vtremblay/ambiens-sc1-ctrl-board/pcb/ambiens-sc1.kicad_pcb

## KiCad design pcb/ambiens-sc1.kicad_pcb (2024-04-04)

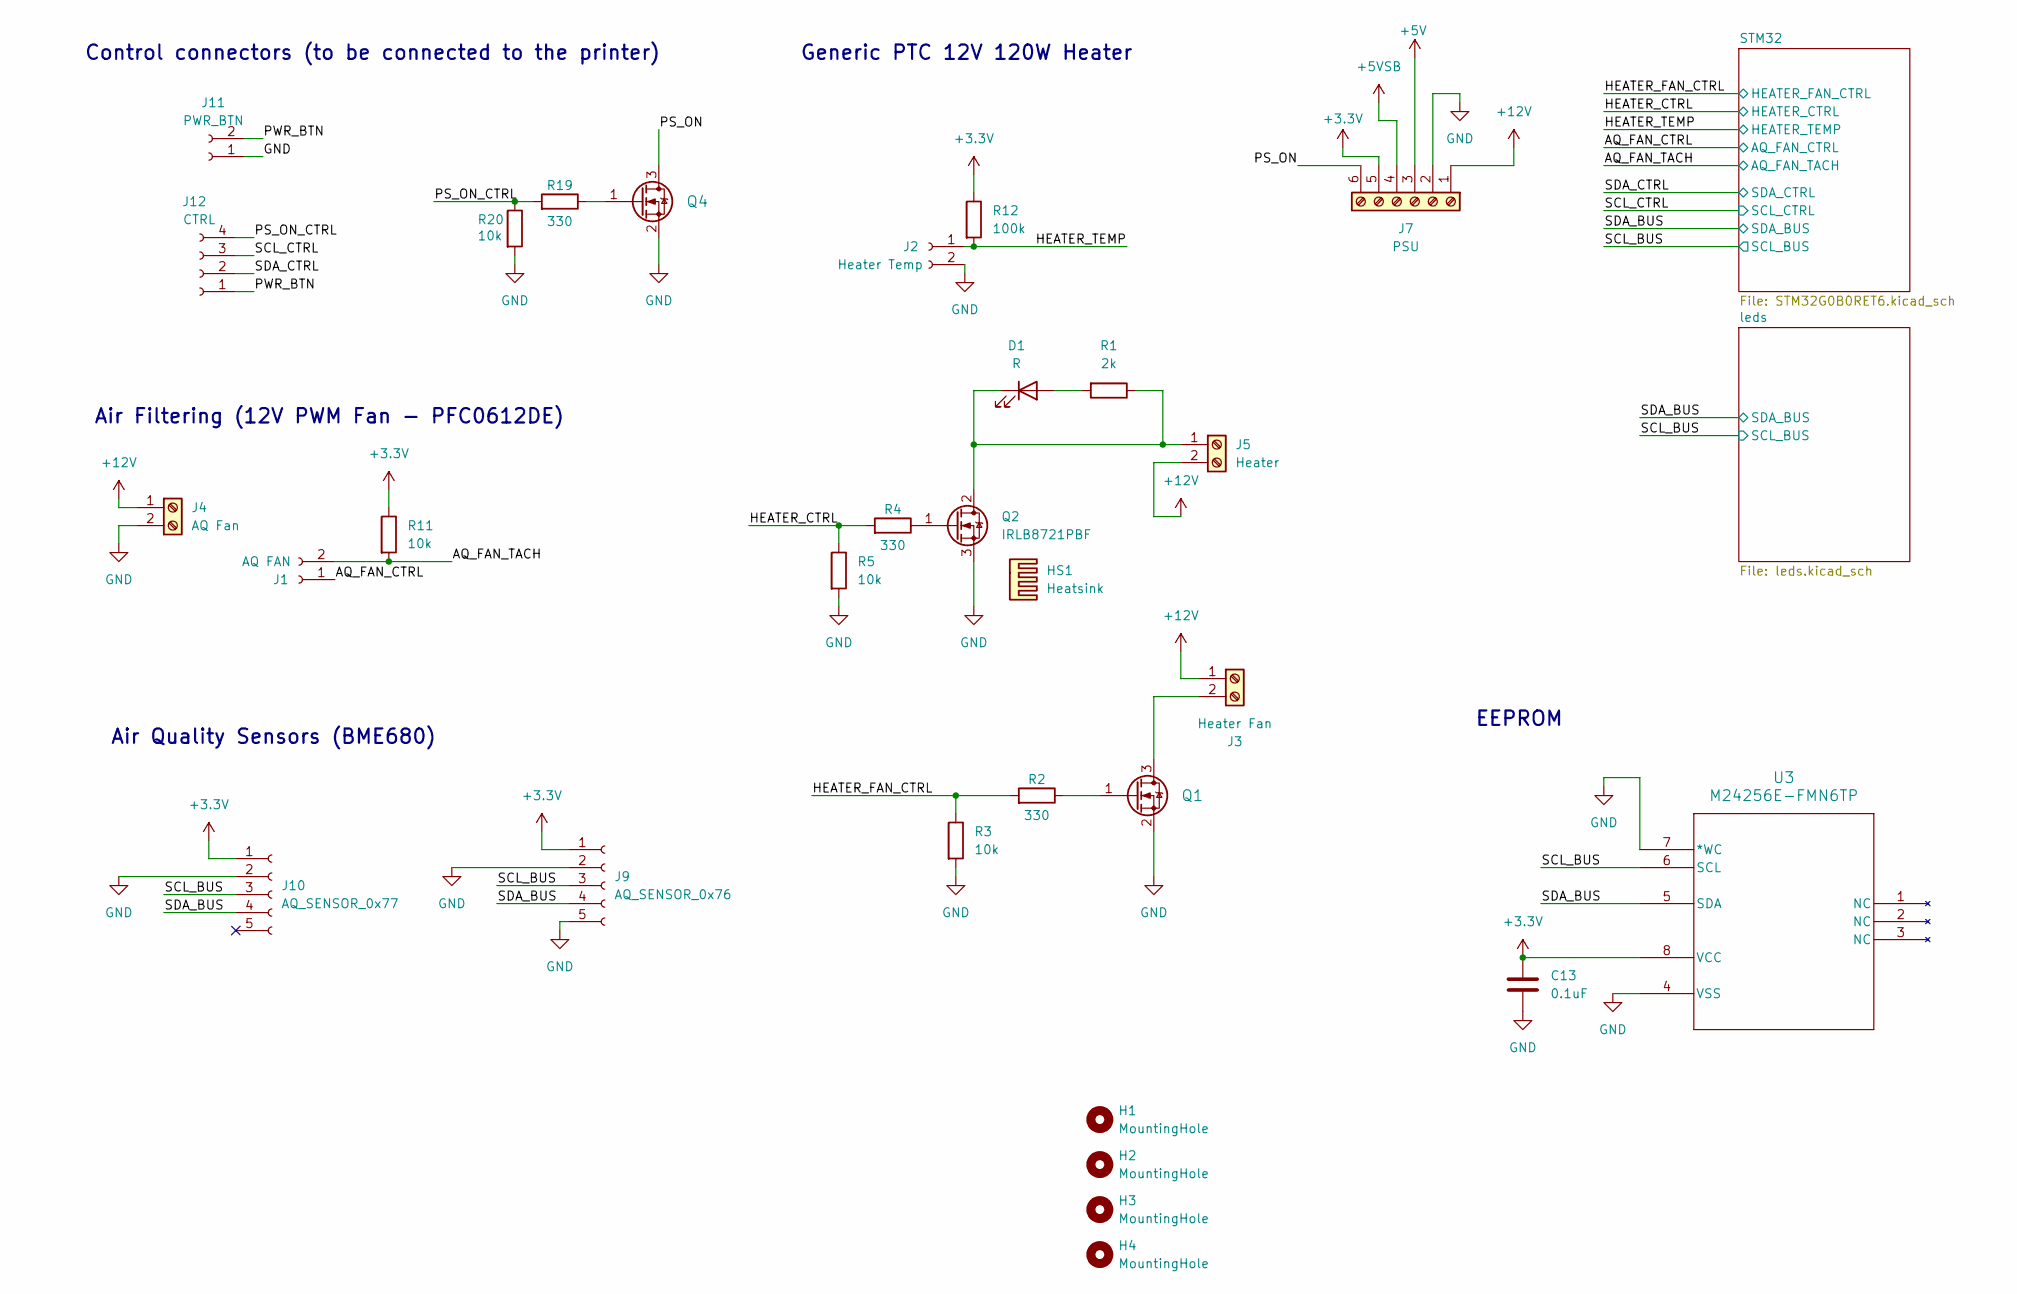
[picture p4: schematic ambiens-sc1.kicad_sch]

Parts:
C13: 0.1uF; C_0603_1608Metric
D1: R; LED_0805_2012Metric
H1, H2, H3, H4: MountingHole; MountingHole_3.2mm_M3
HS1: Heatsink; heatsink-15x10mm
J1: AQ FAN; JST_XH_B2B-XH-A_1x02_P2.50mm_Vertical
J2: Heater Temp; JST_XH_B2B-XH-A_1x02_P2.50mm_Vertical
J3: Heater Fan; TerminalBlock_Phoenix_MKDS-1,5-2_1x02_P5.00mm_Horizontal
J4: AQ Fan; TerminalBlock_Phoenix_MKDS-1,5-2_1x02_P5.00mm_Horizontal
J5: Heater; TerminalBlock_Phoenix_MKDS-1,5-2_1x02_P5.00mm_Horizontal
J7: PSU; TerminalBlock_Phoenix_MKDS-1,5-6-5.08_1x06_P5.08mm_Horizont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
J9: AQ_SENSOR_0x76; JST_XH_B5B-XH-A_1x05_P2.50mm_Vertical
J10: AQ_SENSOR_0x77; JST_XH_B5B-XH-A_1x05_P2.50mm_Vertical
J11: PWR_BTN; JST_XH_B2B-XH-A_1x02_P2.50mm_Vertical
J12: CTRL; JST_XH_B4B-XH-A_1x04_P2.50mm_Vertical
Q1, Q4: SI2302; SOT-23-3
Q2: IRLB8721PBF; TO-220-3_Vertical
R1: 2k; R_0805_2012Metric
R2, R4, R19: 330; R_0805_2012Metric
R3, R5, R11, R20: 10k; R_0805_2012Metric
R12: 100k; R_0805_2012Metric
U3: M24256E-FMN6TP; SO8N_4X5X1P27_STM

Connections:
+3.3V: C13.1, J7.5, J9.1, J10.1, R11.1, R12.1, U3.8 (VCC); also elsewhere on the board
+5V: J7.3; also elsewhere on the board
+5VSB: J7.4; also elsewhere on the board
+12V: J3.1, J4.1, J5.2, J7.1; also elsewhere on the board
/AQ_FAN_CTRL: J1.1; also elsewhere on the board
/AQ_FAN_TACH: J1.2, R11.2; also elsewhere on the board
/HEATER_CTRL: R4.2, R5.1; also elsewhere on the board
/HEATER_FAN_CTRL: R2.2, R3.1; also elsewhere on the board
/HEATER_TEMP: J2.1, R12.2; also elsewhere on the board
/PS_ON: J7.6, Q4.3 (D)
/PS_ON_CTRL: J12.4, R19.2, R20.1
/PWR_BTN: J11.2, J12.1
/SCL_BUS: J9.3, J10.3, U3.6 (SCL); also elsewhere on the board
/SCL_CTRL: J12.3; also elsewhere on the board
/SDA_BUS: J9.4, J10.4, U3.5 (SDA); also elsewhere on the board
/SDA_CTRL: J12.2; also elsewhere on the board
GND: C13.2, J2.2, J4.2, J7.2, J9.2, J9.5, J10.2, J11.1, Q1.2 (S), Q2.3 (S), Q4.2 (S), R3.2, R5.2, R20.2, U3.4 (VSS), U3.7 (*WC); also elsewhere on the board
unnamed: D1.2 (A), R1.2
unnamed: D1.1 (K), J5.1, Q2.2 (D), R1.1
unnamed: J3.2, Q1.3 (D)
unnamed: Q1.1 (G), R2.1
unnamed: Q2.1 (G), R4.1
unnamed: Q4.1 (G), R19.1

Notes on the sheet:
Air Quality Sensors (BME680)
Generic PTC 12V 120W Heater
Control connectors (to be connected to the printer)
EEPROM
Air Filtering (12V PWM Fan - PFC0612DE)

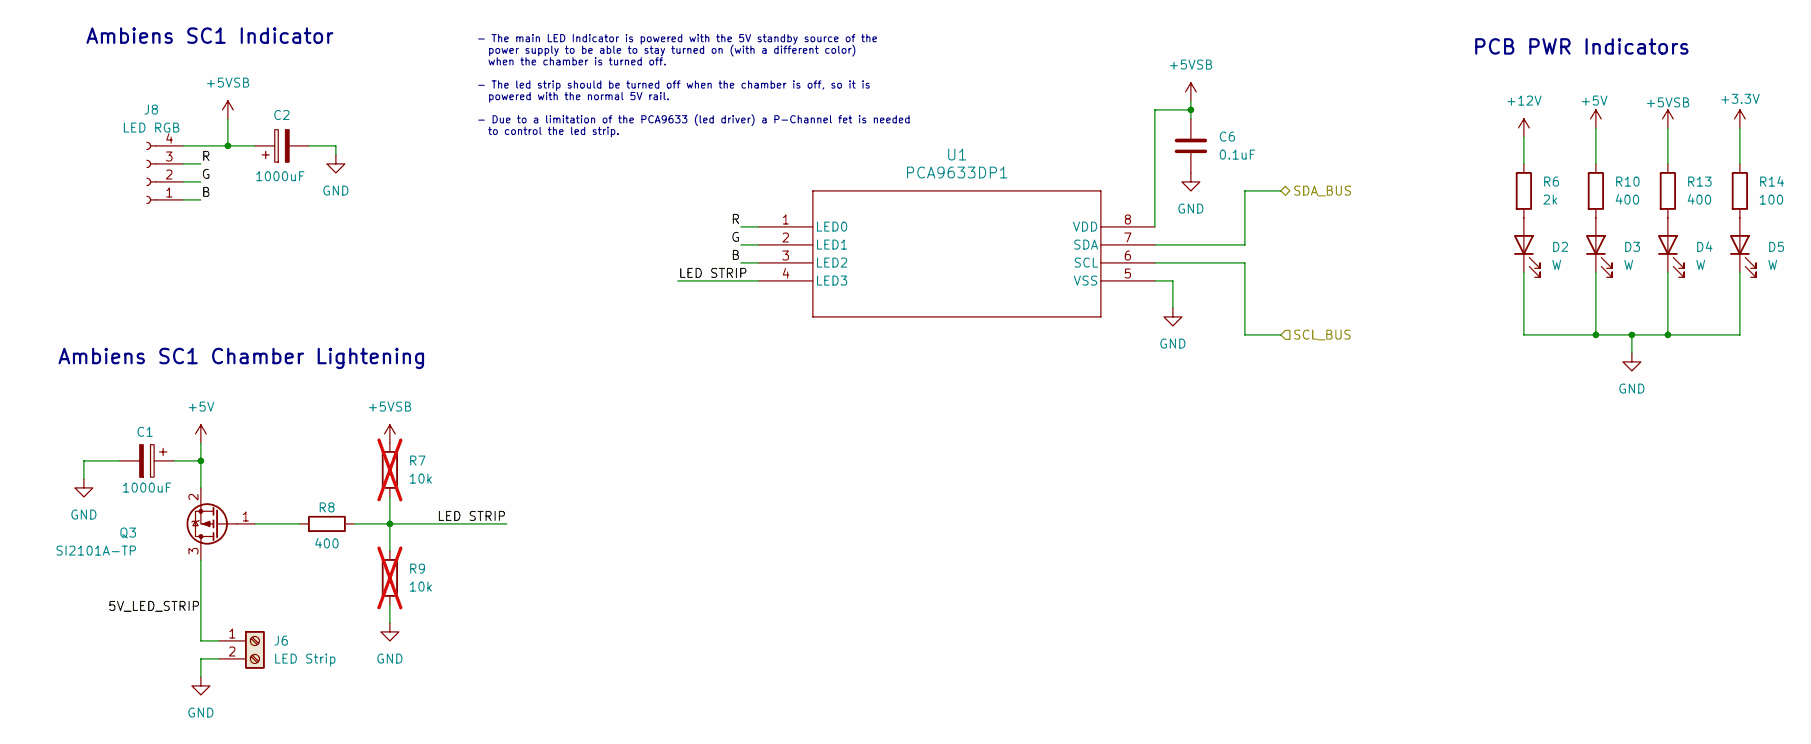
[picture p5: schematic leds.kicad_sch]

Parts:
C1, C2: 1000uF; CP_Radial_D10.0mm_P5.00mm
C6: 0.1uF; C_0603_1608Metric
D2, D3, D4, D5: W; LED_0805_2012Metric
J6: LED Strip; TerminalBlock_Phoenix_MKDS-1,5-2_1x02_P5.00mm_Horizontal
J8: LED RGB; JST_XH_B4B-XH-A_1x04_P2.50mm_Vertical
Q3: SI2101A-TP; SOT65P228X120-3N
R6: 2k; R_0805_2012Metric
R7, R9: 10k; R_0805_2012Metric; not fitted
R8, R10, R13: 400; R_0805_2012Metric
R14: 100; R_0805_2012Metric
U1: PCA9633DP1; SOT505-1_NXP

Connections:
+3.3V: R14.1; also elsewhere on the board
+5V: C1.1, Q3.2 (S), R10.1; also elsewhere on the board
+5VSB: C2.1, C6.1, J8.4, R7.1, R13.1, U1.8 (VDD); also elsewhere on the board
+12V: R6.1; also elsewhere on the board
/SCL_BUS: U1.6 (SCL); also elsewhere on the board
/SDA_BUS: U1.7 (SDA); also elsewhere on the board
/leds/5V_LED_STRIP: J6.1, Q3.3 (D)
/leds/B: J8.1, U1.3 (LED2)
/leds/G: J8.2, U1.2 (LED1)
/leds/LED STRIP: R7.2, R8.1, R9.1, U1.4 (LED3)
/leds/R: J8.3, U1.1 (LED0)
GND: C1.2, C2.2, C6.2, D2.1 (K), D3.1 (K), D4.1 (K), D5.1 (K), J6.2, R9.2, U1.5 (VSS); also elsewhere on the board
unnamed: D2.2 (A), R6.2
unnamed: D3.2 (A), R10.2
unnamed: D4.2 (A), R13.2
unnamed: D5.2 (A), R14.2
unnamed: Q3.1 (G), R8.2

Notes on the sheet:
PCB PWR Indicators
Ambiens SC1 Indicator
- The main LED Indicator is powered with the 5V standby source of the power supply to be able to stay turned on (with a different color) when the chamber is turned off. - The led strip should be turned off when the chamber is off, so it is powered with the normal 5V rail. - Due to a limitation of t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
Ambiens SC1 Chamber Lightening

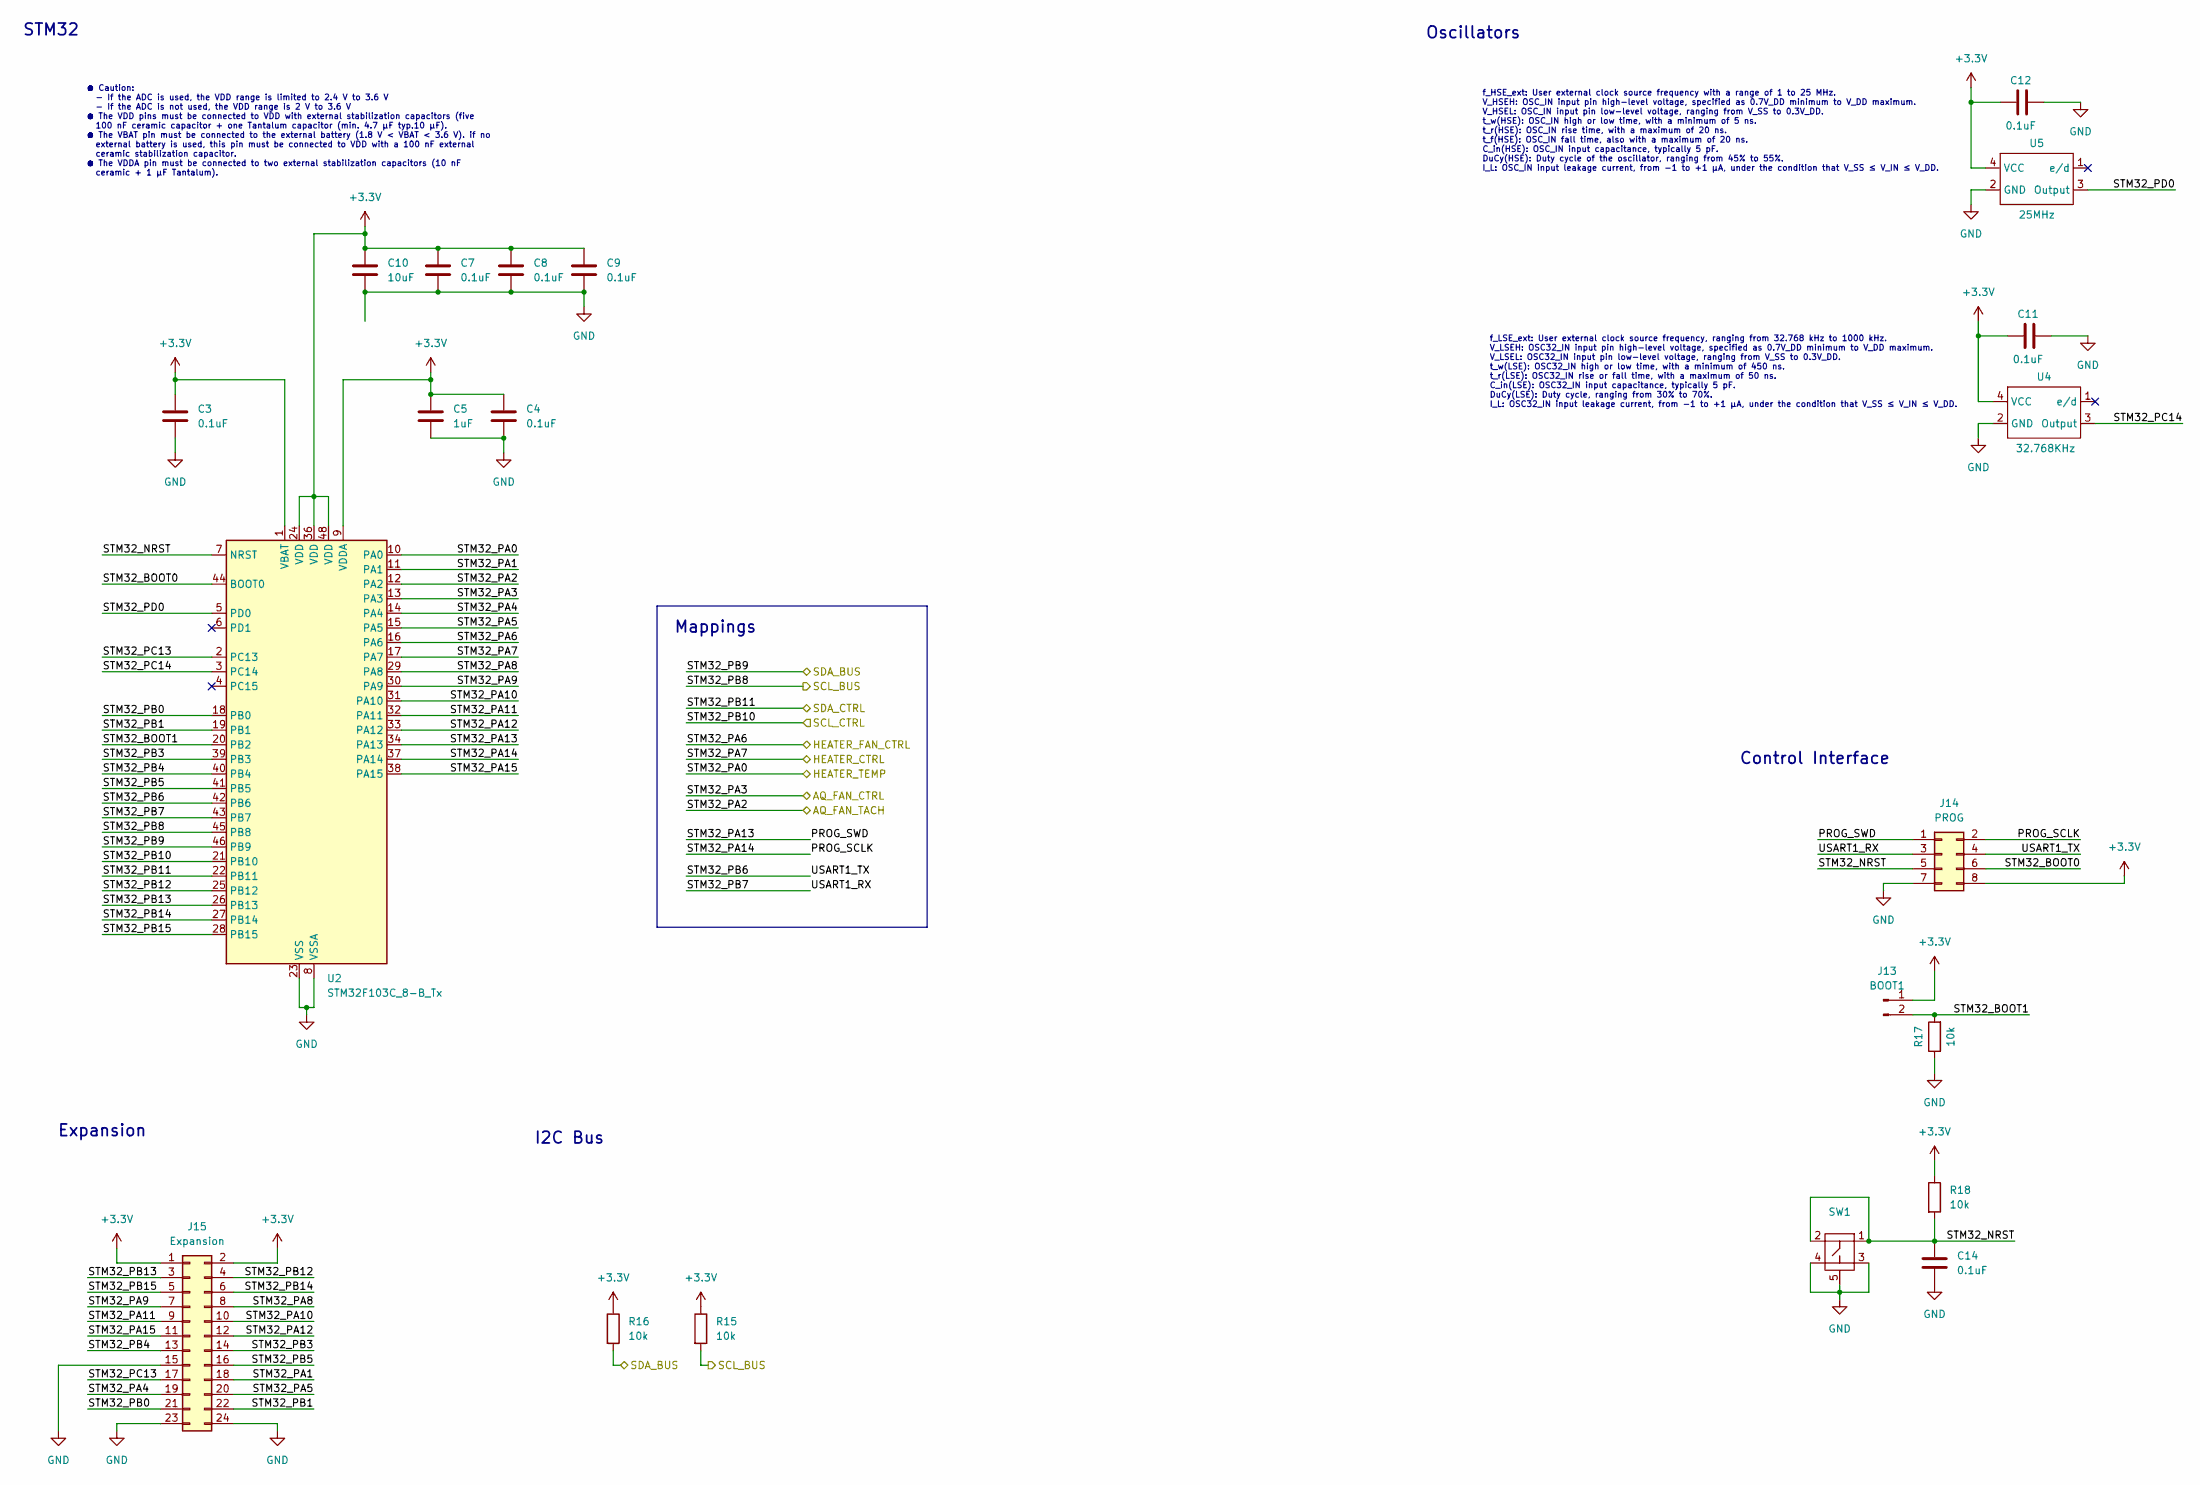
[picture p6: schematic STM32G0B0RET6.kicad_sch]

Parts:
C3, C4, C7, C8, C9, C11, C12, C14: 0.1uF; C_0603_1608Metric
C5: 1uF; C_0805_2012Metric
C10: 10uF; C_0805_2012Metric
J13: BOOT1; PinHeader_1x02_P2.54mm_Vertical
J14: PROG; PinHeader_2x04_P2.54mm_Vertical
J15: Expansion; PinHeader_2x12_P2.54mm_Vertical
R15, R16, R17, R18: 10k; R_0805_2012Metric
SW1: TS3315A
U2: STM32F103C_8-B_Tx; LQFP-48_7x7mm_P0.5mm
U4: 32.768KHz; SX3M32.768
U5: 25MHz; OT322525MJBA4SL

Connections:
+3.3V: C3.1, C4.1, C5.1, C7.1, C8.1, C9.1, C10.1, C11.1, C12.1, J13.1, J14.8, J15.1, J15.2, R15.1, R16.1, R18.1, U2.1 (VBAT), U2.9 (VDDA), U2.24 (VDD), U2.36 (VDD), U2.48 (VDD), U4.4 (VCC), U5.4 (VCC); also elsewhere on the board
/AQ_FAN_CTRL: U2.13 (PA3); also elsewhere on the board
/AQ_FAN_TACH: U2.12 (PA2); also elsewhere on the board
/HEATER_CTRL: U2.17 (PA7); also elsewhere on the board
/HEATER_FAN_CTRL: U2.16 (PA6); also elsewhere on the board
/HEATER_TEMP: U2.10 (PA0); also elsewhere on the board
/SCL_BUS: R15.2, U2.45 (PB8); also elsewhere on the board
/SCL_CTRL: U2.21 (PB10); also elsewhere on the board
/SDA_BUS: R16.2, U2.46 (PB9); also elsewhere on the board
/SDA_CTRL: U2.22 (PB11); also elsewhere on the board
/STM32/PROG_SCLK: J14.2, U2.37 (PA14)
/STM32/PROG_SWD: J14.1, U2.34 (PA13)
/STM32/STM32_BOOT0: J14.6, U2.44 (BOOT0)
/STM32/STM32_BOOT1: J13.2, R17.2, U2.20 (PB2)
/STM32/STM32_NRST: C14.1, J14.5, R18.2, SW1.1, SW1.2, U2.7 (NRST)
/STM32/STM32_PA1: J15.18, U2.11 (PA1)
/STM32/STM32_PA4: J15.19, U2.14 (PA4)
/STM32/STM32_PA5: J15.20, U2.15 (PA5)
/STM32/STM32_PA8: J15.8, U2.29 (PA8)
/STM32/STM32_PA9: J15.7, U2.30 (PA9)
/STM32/STM32_PA10: J15.10, U2.31 (PA10)
/STM32/STM32_PA11: J15.9, U2.32 (PA11)
/STM32/STM32_PA12: J15.12, U2.33 (PA12)
/STM32/STM32_PA15: J15.11, U2.38 (PA15)
/STM32/STM32_PB0: J15.21, U2.18 (PB0)
/STM32/STM32_PB1: J15.22, U2.19 (PB1)
/STM32/STM32_PB3: J15.14, U2.39 (PB3)
/STM32/STM32_PB4: J15.13, U2.40 (PB4)
/STM32/STM32_PB5: J15.16, U2.41 (PB5)
/STM32/STM32_PB6: J14.4, U2.42 (PB6)
/STM32/STM32_PB7: J14.3, U2.43 (PB7)
/STM32/STM32_PB12: J15.4, U2.25 (PB12)
/STM32/STM32_PB13: J15.3, U2.26 (PB13)
/STM32/STM32_PB14: J15.6, U2.27 (PB14)
/STM32/STM32_PB15: J15.5, U2.28 (PB15)
/STM32/STM32_PC13: J15.17, U2.2 (PC13)
/STM32/STM32_PC14: U2.3 (PC14), U4.3 (Output)
/STM32/STM32_PD0: U2.5 (PD0), U5.3 (Output)
GND: C3.2, C4.2, C5.2, C7.2, C8.2, C9.2, C10.2, C11.2, C12.2, C14.2, J14.7, J15.15, J15.23, J15.24, R17.1, SW1.3, SW1.4, SW1.5, U2.8 (VSSA), U2.23 (VSS), U2.35 (VSS), U2.47 (VSS), U4.2 (GND), U5.2 (GND); also elsewhere on the board

Notes on the sheet:
● Caution: - If the ADC is used, the VDD range is limited to 2.4 V to 3.6 V - If the ADC is not used, the VDD range is 2 V to 3.6 V ● The VDD pins must be connected to VDD with external stabilization capacitors (five 100 nF ceramic capacitor + one Tantalum capacitor (min. 4.7 µF typ.10 µF). ● The V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
f_HSE_ext: User external clock source frequency with a range of 1 to 25 MHz. V_HSEH: OSC_IN input pin high-level voltage, specified as 0.7V_DD minimum to V_DD maximum. V_HSEL: OSC_IN input pin low-level voltage, ranging from V_SS to 0.3V_DD. t_w(HSE): OSC_IN high or low time, with a minimum of 5 ns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
Expansion
Oscillators
Control Interface
STM32
I2C Bus
Mappings
f_LSE_ext: User external clock source frequency, ranging from 32.768 kHz to 1000 kHz. V_LSEH: OSC32_IN input pin high-level voltage, specified as 0.7V_DD minimum to V_DD maximum. V_LSEL: OSC32_IN input pin low-level voltage, ranging from V_SS to 0.3V_DD. t_w(LSE): OSC32_IN high or low time, with a 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

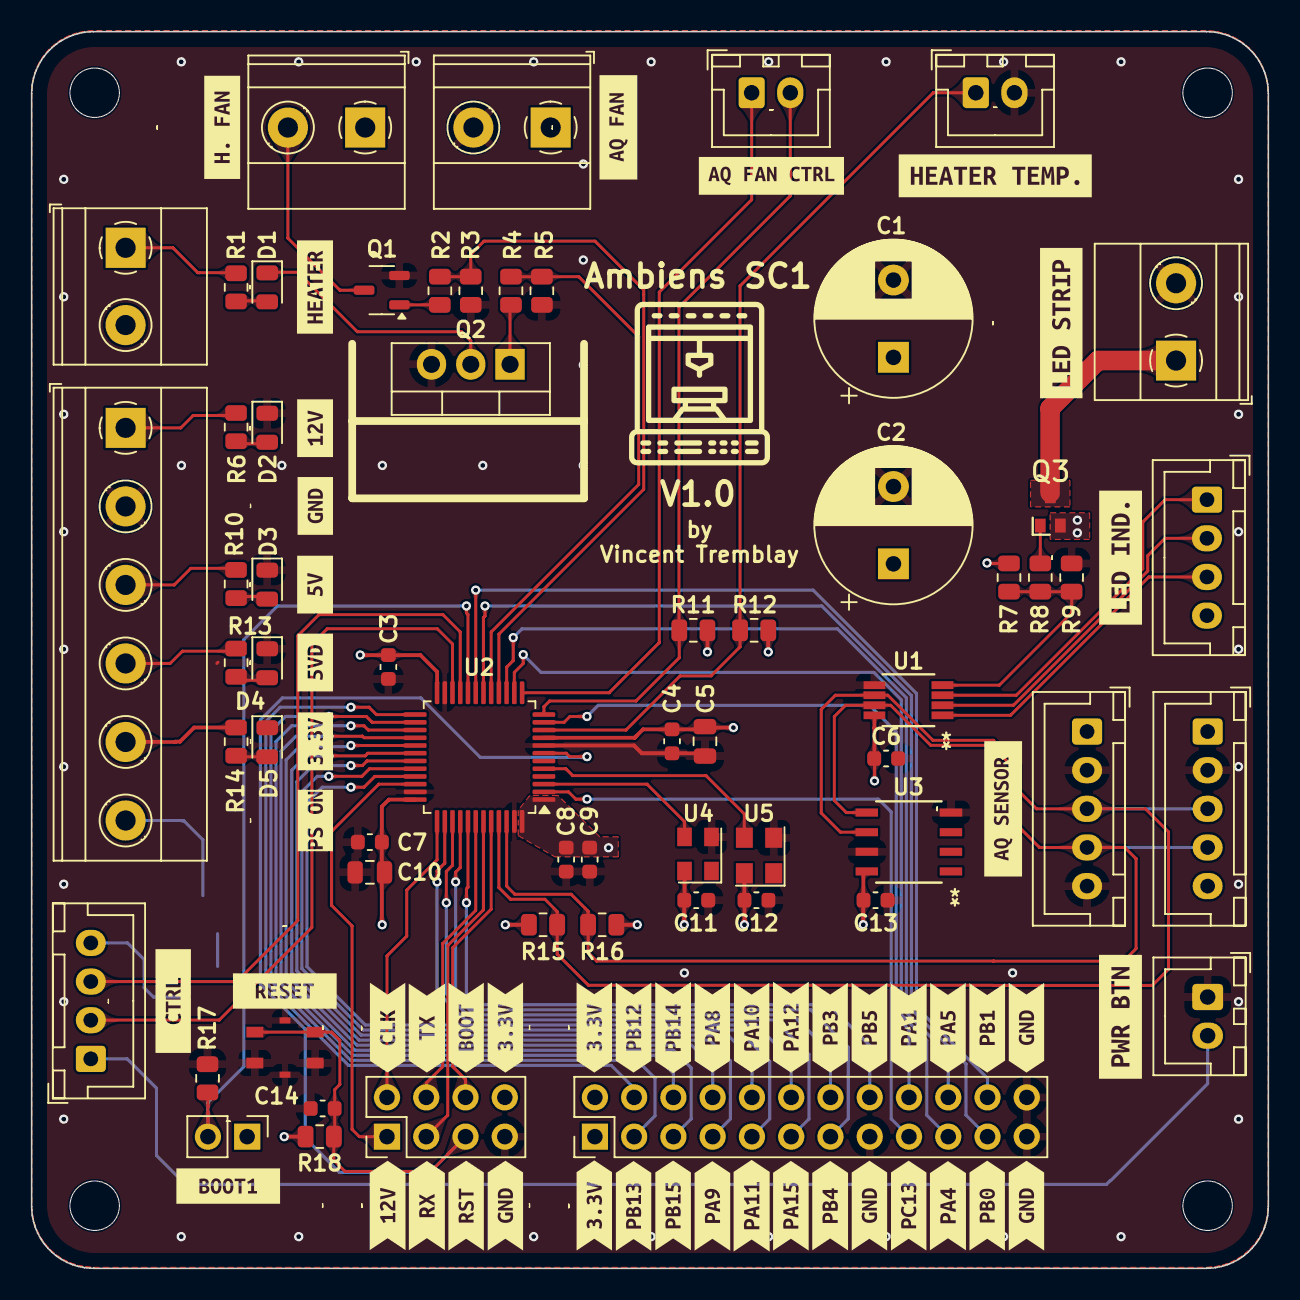
[picture p7: board ambiens-sc1.kicad_pcb from above]

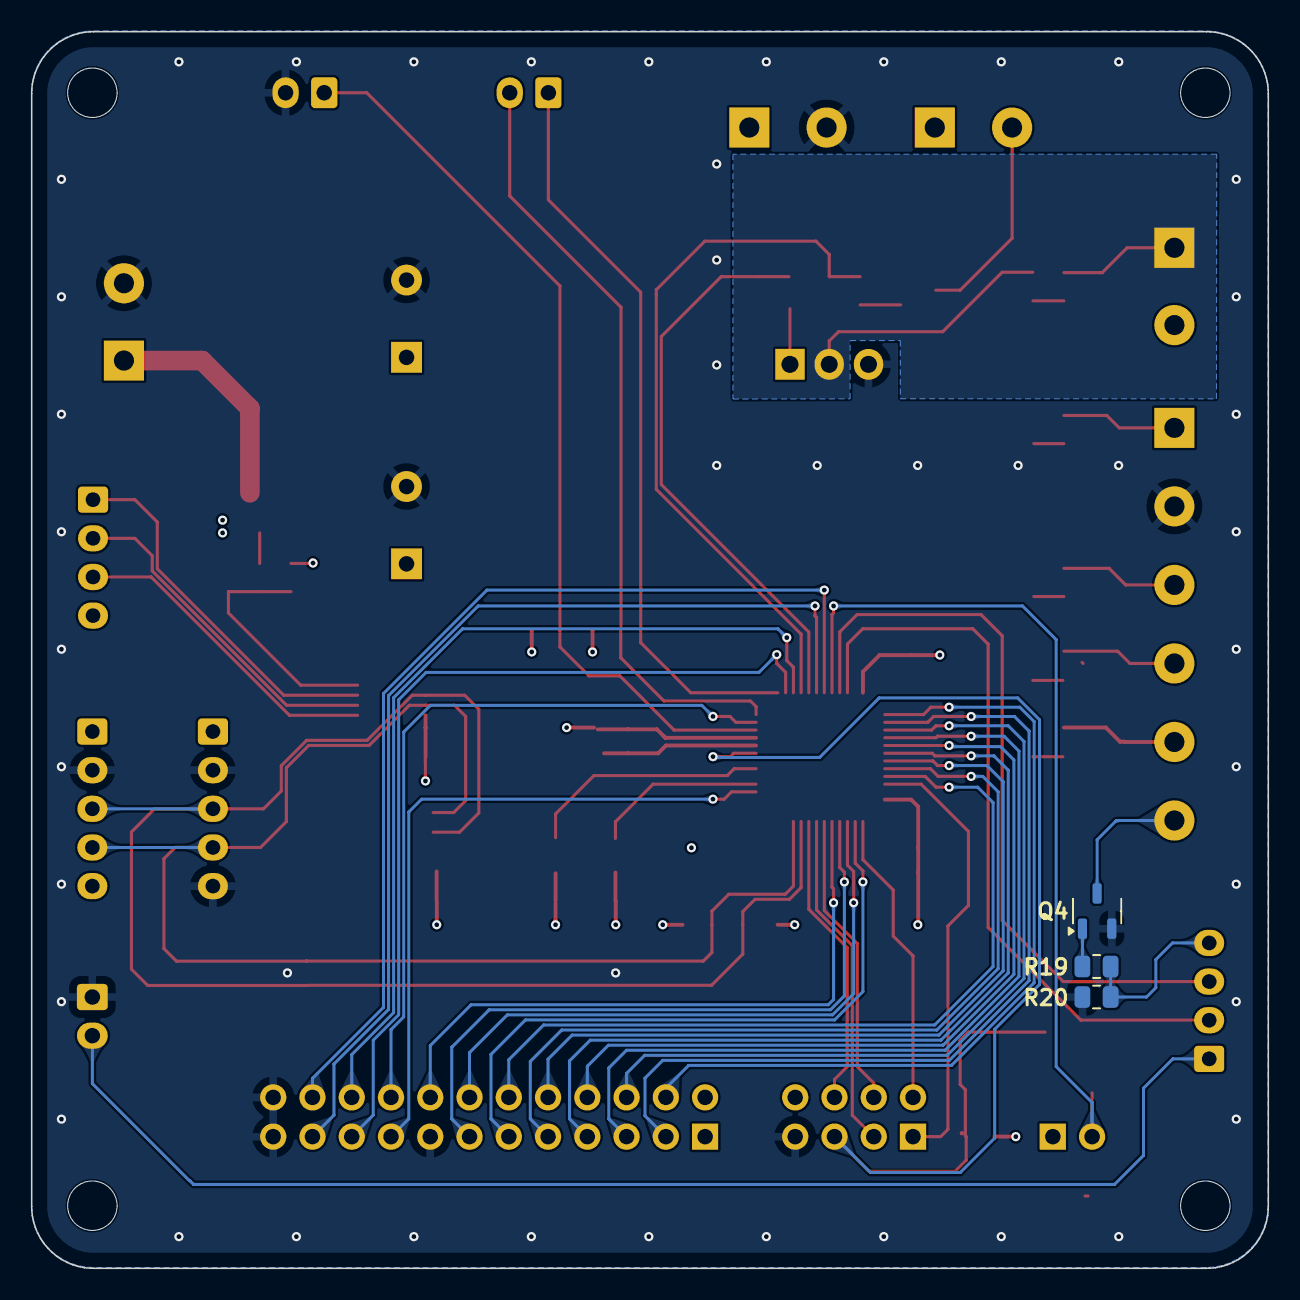
[picture p8: board ambiens-sc1.kicad_pcb from below]

Board: 4 copper layers, 80.0 x 80.0 mm, 119 parts (3 on the bottom side), 61 nets.

Other parts of the board:
kibuzzard-2: G***; kibuzzard-660B36FB
kibuzzard-3: G***; kibuzzard-660B379A
kibuzzard-4: G***; kibuzzard-660B3822
kibuzzard-5: G***; kibuzzard-660B3897
kibuzzard-6: G***; kibuzzard-660B3677
kibuzzard-7: G***; kibuzzard-660B3911
kibuzzard-8: G***; kibuzzard-660B3380
kibuzzard-9: G***; kibuzzard-660B338A
kibuzzard-10: G***; kibuzzard-660B3947
kibuzzard-11: G***; kibuzzard-660B3393
kibuzzard-12: G***; kibuzzard-660B339B
kibuzzard-13: G***; kibuzzard-660B33A2
kibuzzard-14: G***; kibuzzard-660B3A88
kibuzzard-15: G***; kibuzzard-660B3361
kibuzzard-16: G***; kibuzzard-660B3C6C
kibuzzard-17: G***; kibuzzard-660B3B0F
kibuzzard-18: G***; kibuzzard-660D448F
kibuzzard-19: G***; kibuzzard-66046388
kibuzzard-20: G***; kibuzzard-660AE3B8
kibuzzard-21: G***; kibuzzard-66072EC4
kibuzzard-22: G***; kibuzzard-660AD604
kibuzzard-23: G***; kibuzzard-6604645B
kibuzzard-24: G***; kibuzzard-66072F4D
kibuzzard-25: G***; kibuzzard-660B1E5B
kibuzzard-26: G***; kibuzzard-66072F6D
kibuzzard-27: G***; kibuzzard-66072F74
kibuzzard-28: G***; kibuzzard-66072F85
kibuzzard-29: G***; kibuzzard-660463B7
kibuzzard-30: G***; kibuzzard-66072F98
kibuzzard-31: G***; kibuzzard-660B1183
kibuzzard-32: G***; kibuzzard-660B0DE1
kibuzzard-33: G***; kibuzzard-660B118A
kibuzzard-34: G***; kibuzzard-660AE448
kibuzzard-35: G***; kibuzzard-660B3B39
kibuzzard-36: G***; kibuzzard-660B1ED2
kibuzzard-37: G***; kibuzzard-66045831
kibuzzard-38: G***; kibuzzard-66072EDA
kibuzzard-39: G***; kibuzzard-660AE44F
kibuzzard-40: G***; kibuzzard-660AD65A
kibuzzard-41: G***; kibuzzard-66046448
kibuzzard-42: G***; kibuzzard-660B0F13
kibuzzard-43: G***; kibuzzard-660B1175
kibuzzard-44: G***; kibuzzard-660B0DE8
kibuzzard-45: G***; kibuzzard-66072EED
kibuzzard-46: G***; kibuzzard-66072EF6
kibuzzard-47: G***; kibuzzard-66072EFF
kibuzzard-48: G***; kibuzzard-660B117C
kibuzzard-49: G***; kibuzzard-66072F2C
kibuzzard-50: G***; kibuzzard-66072ED0
kibuzzard-51: G***; kibuzzard-66072EE1
